Asbjoern/wifiLCD/pcb/wifilcd.kicad_pcb

## KiCad design pcb/wifilcd.kicad_pcb (2015-07-08)

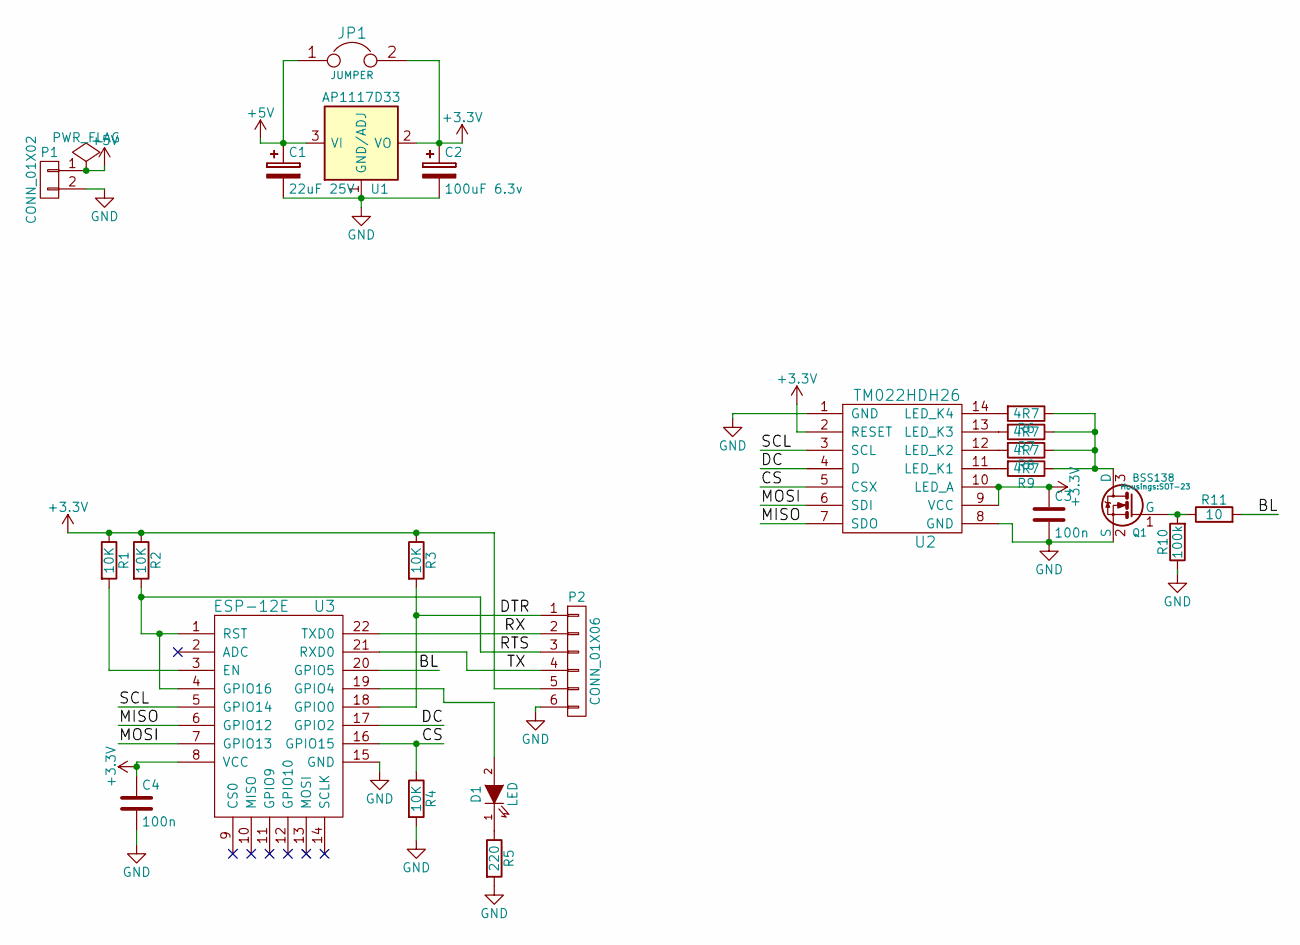
[picture p1: schematic wifilcd.sch, Wifi LCDs]

Parts:
C1: 22uF 25V; TantalC_SizeT_EIA-3528
C2: 100uF 6.3v; TantalC_SizeT_EIA-3528
C3, C4: 100n; C_0603
D1: LED; LED-0603
JP1: JUMPER; R_0603_HandSoldering
P1: CONN_01X02; Pin_Header_Angled_1x02
P2: CONN_01X06; Pin_Header_Angled_2x03
Q1: BSS138; SOT-23
R1, R2, R3, R4: 10K; R_0603
R5: 220; R_0603
R6, R7, R8, R9: 4R7; R_0603
R10: 100k; R_0603
R11: 10; R_0603
U1: AP1117D33; SOT-223
U2: TM022HDH26; TM022HDH26_PADSONLY
U3: ESP-12E

Connections:
+3V3: C2.1, C3.1, C4.1, JP1.2, P2.5, R1.1, R2.1, R3.1, U1.2 (VO), U2.2 (RESET), U2.9 (VCC), U2.10 (LED_A), U3.8 (VCC)
+5V: C1.1, JP1.1, P1.1, U1.3 (VI)
/BL: R11.2, U3.20 (GPIO5)
/CS: R4.1, U2.5 (CSX), U3.16 (GPIO15)
/DC: U2.4 (D), U3.17 (GPIO2)
/DTR: P2.1, R3.2, U3.18 (GPIO0)
/MISO: U2.7 (SDO), U3.6 (GPIO12)
/MOSI: U2.6 (SDI), U3.7 (GPIO13)
/RTS: P2.3, R2.2, U3.1 (RST), U3.4 (GPIO16)
/RX: P2.2, U3.22 (TXD0)
/SCL: U2.3 (SCL), U3.5 (GPIO14)
/TX: P2.4, U3.21 (RXD0)
GND: C1.2, C2.2, C3.2, C4.2, P1.2, P2.6, Q1.2 (S), R4.2, R5.2, R10.1, U1.1 (GND/ADJ), U2.1 (GND), U2.8 (GND), U3.15 (GND)
unnamed: D1.1 (K), R5.1
unnamed: D1.2 (A), U3.19 (GPIO4)
unnamed: Q1.1 (G), R10.2, R11.1
unnamed: Q1.3 (D), R6.1, R7.1, R8.1, R9.1
unnamed: R1.2, U3.3 (EN)
unnamed: R6.2, U2.14 (LED_K4)
unnamed: R7.2, U2.13 (LED_K3)
unnamed: R8.2, U2.12 (LED_K2)
unnamed: R9.2, U2.11 (LED_K1)

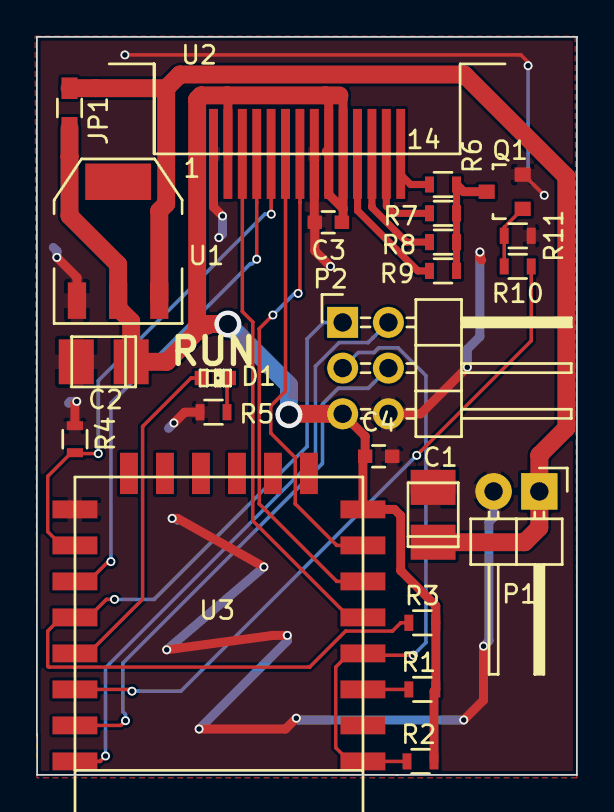
[picture p2: board wifilcd.kicad_pcb from above]

Board: 2 copper layers, 30.0 x 41.0 mm, 23 parts (0 on the bottom side), 22 nets.
