Asbjoern/wifiLCD/(commit log)

2015-06-22 Added KiCad files for PCB
    [wifilcd.kicad_pcb, wifilcd.sch]
2015-06-22 PCB: Fixed library path
2015-06-23 Backlight crashed if set in Setup(). Moved to LOOP Recovery AP now named WiFiLCD Recovery instead of name in settings.
    [wifiLCD.ino]
2015-06-23 Fixed allowPUT switch + cleanup
    [settings.cpp, settings.h]
2015-07-08 Switched to Adafruits LCD library
2015-07-08 Minor PCB changes
    [wifilcd.kicad_pcb, wifilcd.sch]
2015-07-23 Added OTA switch to webconfig
2016-02-23 Updated pcb to new KiCad
